sfrwmaker/hakko_t12/schematics/hakko_t12.png

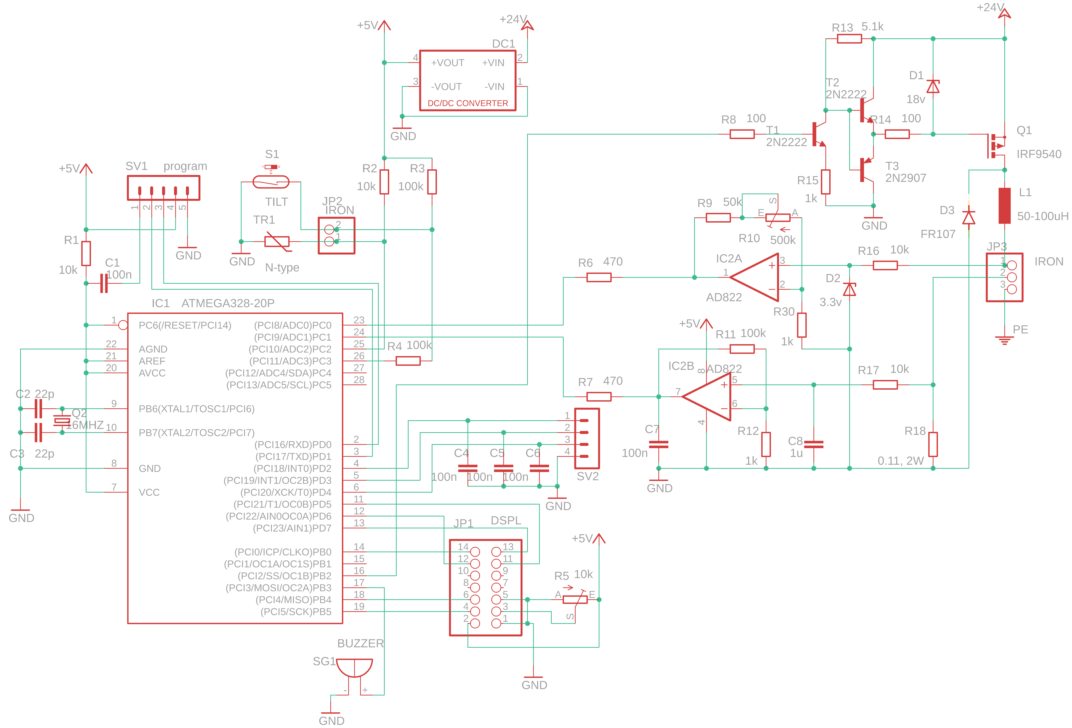
schematics/hakko_t12.png
