sfrwmaker/hakko_t12/(threads)

Thread 1 (2019-08-29):

Preset temperature jumps when finished rotating the encoder

phatina, 2019-08-29:
In fast decrement mode, I set the temperature to lowest value 180C, then the Iron jumps to 173. This happens only when setting temperature down.

phatina, 2019-08-31:
I tried to follow instructions mentioned [here](https://www.hackster.io/sfrwmaker/soldering-iron-controller-for-hakko-t12-tips-on-arduino-f7a888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); now 180C jumps to 150C. Can you guide me, please?

Maybe I am not seeing a bug, but my iron is *not* properly set.

Thanks.

sfrwmaker, 2019-08-31:
Hello!

It's fine, you have found right manual.
Can you explain in more details what the issue is?

phatina, 2019-08-31:
I enter `tip cfg` menu and fire up 200C calibration. Tip reaches approximately 200C, which I verified using a thermocouple. Iron then displays `rdy` on the first line. Then I long press the encoder to leave config. menu. Rotating the encoder I set e.g. temperature 180C, after a second, it jumps to 150C (I suspect, there's something wrong in mapping of the internal 0-1023 value to human readable).

Am I doing something wrong?

Thanks a lot!

sfrwmaker, 2019-08-31:
Hello!

Now i can understand what the issue is. You must calibrate the soldering tip through all the calibration points. Also, i do recommend to calibrate each point several times. The problem is that the controller tries to build three lines through the calibration points. When your tip 'mapping' is different from the standard one, you can get wrong result.

phatina, 2019-09-01:
Aha.

So I enter `tip cfg` menu and start at 200C point - here I press the encoder to start heating. Once I see `rdy` message I verify the actual temperature against the one on the display. Then I move to 300C and 400C. When Finished, I do a long press to leave `tip cfg` screen and that's it?

sfrwmaker, 2019-09-01:
Correct. Also, you can configure these points several times for accuracy.

phatina, 2019-09-01:
Is it possible to do this only for 200C and 300C points and leave 400C point?

phatina, 2019-09-01:
OK, I followed your instructions and did calibrate the tip for every temperature (200, 300 and 400C). I still see weird low temperature when set to 180C (152C).

sfrwmaker, 2019-09-01:
Hello!

I think, you can change the reference temperature values. Look at line #35 os the sketch:
const uint16_t temp_tip[3] = {200, 300, 400};   // Reference temperatures for tip calibration (Celsius)
If you require to correctly setup the 180 degrees, i would recommend to setup 150, 200 and 300 degrees as reference points.
Not sure, the controller can keep 180 degrees correctly because of very low PWM signal duty cycle. I mean in low duty we can face low accuracy. Let's see 5 and 6 are closest values, but the difference is 20%.
It the controller cannot keep the temperature accurately, you can use 12v power supply.

phatina, 2019-09-02:
Hi,

me personally, I do not need 180C that much. At this point, I can see the jump at most. I set e.g. 185, 190C and after half a second, the temperature on display jumps to 156C or so. This is annoying.

I tried to use older code from git history which does not use calibration at all, but then no tip is recognized.

Do you have any advice?

phatina, 2019-09-03:
I created a [Pull Request](https://github.com/sfrwmaker/hakko_t12/pull/2) with fix for this. Please review.

sfrwmaker, 2019-09-05:
New version of firmware uploaded. Please, check it out.

phatina, 2019-09-06:
Yes, now it works as expected. So I can close my PR... BTW, Please try to be more descriptive in your commits; and also stage changes so that they form a logical change.

Anyway, thanks for being supportive! :+1:

Closed 2019-09-06.

Thread 3 (2020-05-02):

Update link of Instructables

scarrrr316, 2020-05-02:
Same as title
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

sfrwmaker, 2020-05-07:
Updated URL

scarrrr316, 2020-06-21:
and please add more information on your schematic ！！I think it is hard to uderstand the usage of those socket，e.g.sv2 （maybe its my problem）

sfrwmaker, 2020-06-22:
Hello! Sorry for my complicated style. Sv2 socket used to connect rotary encoder. I will describe it in the tutorial later, after my vacations over. Right now i have limited Internet access.

scarrrr316, 2020-06-22:
ohhhhhhhhh，thankyou very much

scarrrr316, 2020-06-23:
what is the usage of jp2？

Thread 4 (2022-04-07):

Why is there a 10K (R1) resistor between +5V and VCC, AVCC, and AREF on the AVR?

DavidGriffith, 2022-04-07:
It's clear that you're using R1 to pull up the AVR's /RESET line.  Why then are VCC, AVCC, and AREF also tied to /RESET?
