sfrwmaker/hakko_t12/schematics/hakko_t12.sch

## EAGLE design schematics/hakko_t12.sch (2020-05-20)

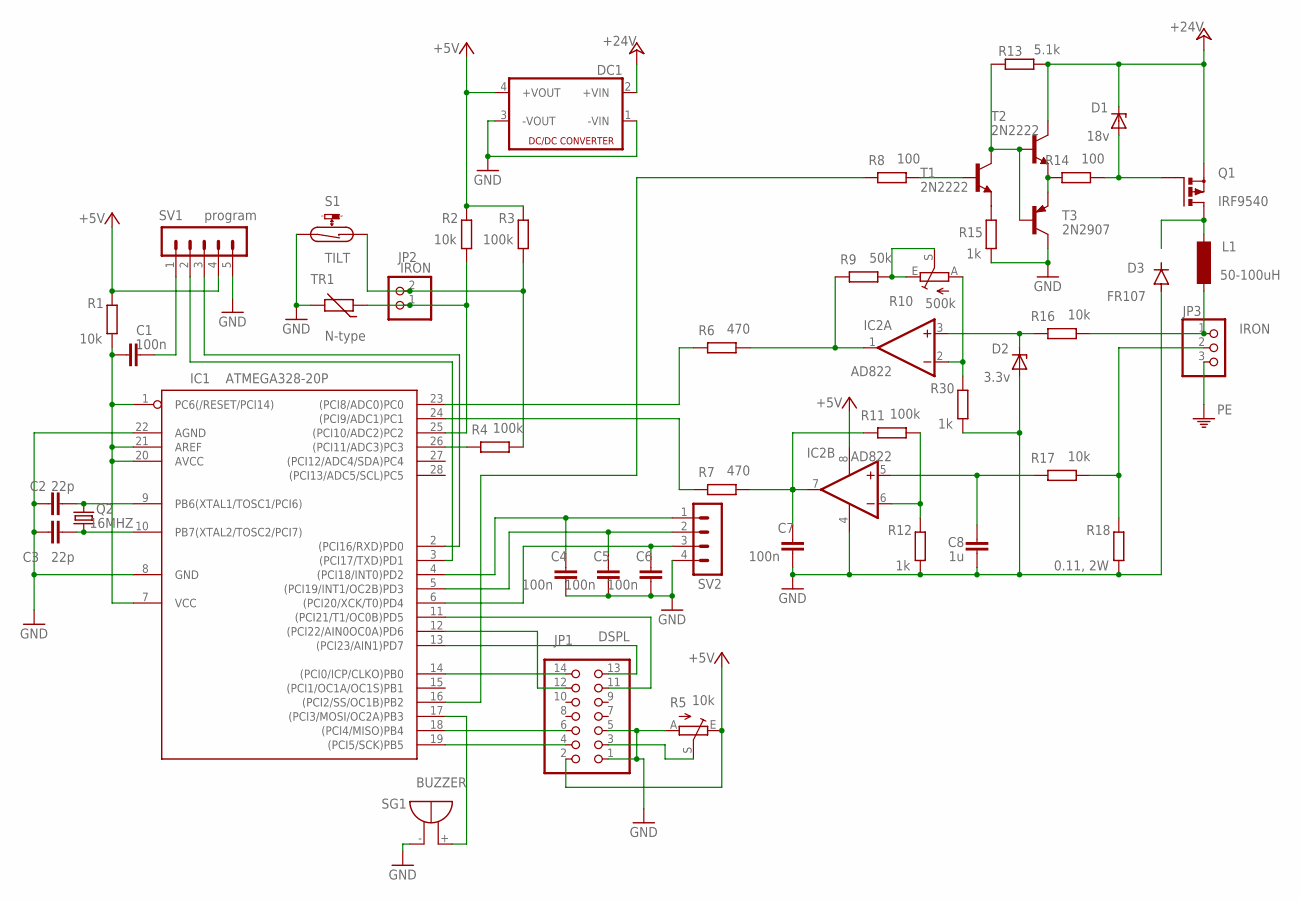
[picture p2: schematic hakko_t12.sch]

Parts:
C1, C4, C5, C6, C7: 100n; C0805
C2, C3: 22p; C0805
C8: 1u; C0805
D1: 18v; C1702-15
D2: 3.3v; C1702-15
D3: FR107; DO41-10
DC1: NME
IC1: ATMEGA328-20P; DIL28-3
IC2: AD822; DIL08
JP1: DSPL; 2X07
JP2: IRON; 1X02
JP3: IRON; 1X03
L1: 50-100uH; SD8
Q1: IRF9540; TO220BH
Q2: 16MHZ; HC49/S
R1, R2, R16, R17: 10k; R0805
R3, R4, R11: 100k; R0805
R5: 10k; B25P
R6, R7: 470; R0805
R8, R14: 100; R0805
R9: 50k; R0805
R10: 500k; RJ9W
R12, R15, R30: 1k; R0805
R13: 5.1k; R0805
R18: 0.11, 2W; R0805
S1: TILT; CT10-A2
SG1: BUZZER; EB2209A
SV1: program; MA05-1
SV2: MA04-1
T1, T2: 2N2222; TO18
T3: 2N2907; TO18
TR1: N-type; R-5

Connections:
+5V: DC1.4 (+VOUT), IC2.8 (V+), JP1.2, R1.2, R2.2, R3.2, R5.E, SV1.4
+24V: D1.C, DC1.2 (+VIN), Q1.S, R13.2, T2.3 (C)
GND: C2.1, C3.1, C4.2, C5.2, C6.2, C7.2, C8.2, D2.A, D3.A, DC1.1 (-VIN), DC1.3 (-VOUT), IC1.8 (GND), IC1.22 (AGND), IC2.4 (V-), JP1.1, JP1.5, R5.A, R12.1, R15.1, R18.1, R30.1, S1.2, SG1.-, SV1.5, SV2.4, T3.3 (C), TR1.2
unnamed: C2.2, IC1.9 (PB6(XTAL1/TOSC1/PCI6)), Q2.2
unnamed: C3.2, IC1.10 (PB7(XTAL2/TOSC2/PCI7)), Q2.1
unnamed: C4.1, IC1.4 ((PCI18/INT0)PD2), SV2.1
unnamed: C1.2, SV1.1
unnamed: C5.1, IC1.5 ((PCI19/INT1/OC2B)PD3), SV2.2
unnamed: C1.1, IC1.1 (PC6(/RESET/PCI14)), IC1.7 (VCC), IC1.20 (AVCC), IC1.21 (AREF), R1.1
unnamed: IC1.3 ((PCI17/TXD)PD1), SV1.2
unnamed: IC1.2 ((PCI16/RXD)PD0), SV1.3
unnamed: C6.1, IC1.6 ((PCI20/XCK/T0)PD4), SV2.3
unnamed: IC1.11 ((PCI21/T1/OC0B)PD5), JP1.11
unnamed: IC1.13 ((PCI23/AIN1)PD7), JP1.13
unnamed: IC1.19 ((PCI5/SCK)PB5), JP1.4
unnamed: IC1.14 ((PCI0/ICP/CLKO)PB0), JP1.14
unnamed: IC1.12 ((PCI22/AIN0OC0A)PD6), JP1.12
unnamed: JP1.3, R5.S
unnamed: IC1.18 ((PCI4/MISO)PB4), JP1.6
unnamed: IC1.17 ((PCI3/MOSI/OC2A)PB3), SG1.+
unnamed: C7.1, IC2.7 (OUT), R7.2, R11.1
unnamed: IC1.24 ((PCI9/ADC1)PC1), R7.1
unnamed: IC2.6 (-IN), R11.2, R12.2
unnamed: IC1.25 ((PCI10/ADC2)PC2), JP2.1, R2.1, TR1.1
unnamed: IC1.26 ((PCI11/ADC3)PC3), R4.1
unnamed: C8.1, IC2.5 (+IN), R17.1
unnamed: JP2.2, R3.1, R4.2, S1.1
unnamed: R9.2, R10.E, R10.S
unnamed: IC2.2 (-IN), R10.A, R30.2
unnamed: IC2.1 (OUT), R6.2, R9.1
unnamed: D2.C, IC2.3 (+IN), R16.1
unnamed: IC1.23 ((PCI8/ADC0)PC0), R6.1
unnamed: JP3.1, L1.1, R16.2
unnamed: L1.2, Q1.D
unnamed: D1.A, Q1.G, R14.2
unnamed: R14.1, T2.1 (E), T3.1 (E)
unnamed: R13.1, T1.3 (C), T2.2 (B), T3.2 (B)
unnamed: R15.2, T1.1 (E)
unnamed: R8.2, T1.2 (B)
unnamed: IC1.16 ((PCI2/SS/OC1B)PB2), R8.1
unnamed: JP3.2, R17.2, R18.2
PE: JP3.3
