sfrwmaker/hakko_t12/iron_tips.cpp

#include <string.h>
#include "iron_tips.h"

static const char tip_names[][tip_name_sz] PROGMEM = {
		{'B', '\0', '\0', '\0', '\0'},
		{'B', '1',  '\0', '\0', '\0'},
		{'B', '2',  '\0', '\0', '\0'},
		{'B', '3',  '\0', '\0', '\0'},
		{'B', '4',  '\0', '\0', '\0'},
		{'B', '2',  'Z',  '\0', '\0'},
		{'B', 'C',  '1',  '\0', '\0'},
		{'B', 'C',  '1',  '.' ,  '5'},
		{'B', 'C',  '2',  '\0', '\0'},
		{'B', 'C',  '3',  '\0', '\0'},
		{'B', 'C',  '1',  'Z',  '\0'},
		{'B', 'C',  '2',  'Z',  '\0'},
		{'B', 'C',  '4',  'Z',  '\0'},
		{'B', 'C',  'F',  '1',  '\0'},
		{'B', 'C',  'F',  '2',  '\0'},
		{'B', 'C',  'F',  '3',  '\0'},
		{'B', 'C',  'F',  '4',  '\0'},
		{'B', 'C',  'F',  '1',   'Z'},
		{'B', 'C',  'F',  '2',   'Z'},
		{'B', 'C',  'F',  '3',   'Z'},
		{'B', 'C',  'M',  '2',  '\0'},
		{'B', 'C',  'M',  '3',  '\0'},
		{'B', 'L', '\0', '\0',  '\0'},
		{'B', 'Z', '\0', '\0',  '\0'},
		{'C', '1', '\0', '\0',  '\0'},
		{'C', '2', '\0', '\0',  '\0'},
		{'C', '3', '\0', '\0',  '\0'},
		{'C', '4', '\0', '\0',  '\0'},
		{'D', '0',  '8', '\0',  '\0'},
		{'D', '1',  '2', '\0',  '\0'},
		{'D', '1',  '6', '\0',  '\0'},
		{'D', '2',  '4', '\0',  '\0'},
		{'D', '5',  '2', '\0',  '\0'},
		{'D', '4', '\0', '\0',  '\0'},
		{'D', 'L',  '1',  '2',  '\0'},
		{'D', 'L',  '3',  '2',  '\0'},
		{'D', 'L',  '5',  '2',  '\0'},
		{'D', '1',  '2',  'Z',  '\0'},
		{'D', '2',  '4',  'Z',  '\0'},
		{'D', '4',  'Z', '\0',  '\0'},
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
};

static uint16_t tip_number	= sizeof(tip_names) / tip_name_sz;

uint16_t TIPS::tipsLoaded(void) {
	return tip_number;
}

bool TIPS::name(char tip_n[tip_name_sz], uint8_t index) {
	if (index < tip_number) {
        for (uint8_t c = 0; c < tip_name_sz; ++c)
            tip_n[c] = pgm_read_byte(&tip_names[index][c]);
		return true;
	} else {
        for (uint8_t c = 0; c < tip_name_sz; ++c)
            tip_n[c] = '?';
	}
	return false;
}

int8_t TIPS::index(const char name[tip_name_sz]) {
    for (uint16_t i = 0; i < tip_number; ++i) {
        char tip_n[tip_name_sz];
        for (uint8_t c = 0; c < tip_name_sz; ++c)
            tip_n[c] = pgm_read_byte(&tip_names[i][c]);
        if (strncmp(name, tip_n, tip_name_sz) == 0) {
            return i;
        }
    }
    return -1;
}
