sfrwmaker/hakko_t12/vars.h

#ifndef _VARS_H
#define _VARS_H
#include <Arduino.h>

extern const uint16_t default_temperature;
extern const uint16_t temp_max;
extern const uint16_t temp_minC;
extern const uint16_t temp_maxC;
extern const uint16_t temp_minF;
extern const uint16_t temp_maxF;
extern const uint16_t temp_tip[3];
extern const uint16_t ambient_tempC;
extern const uint16_t ambient_tempF;

#endif
